Aman-Sangram/Under_water-localisation/rov 8 inch mounting/1.PNG

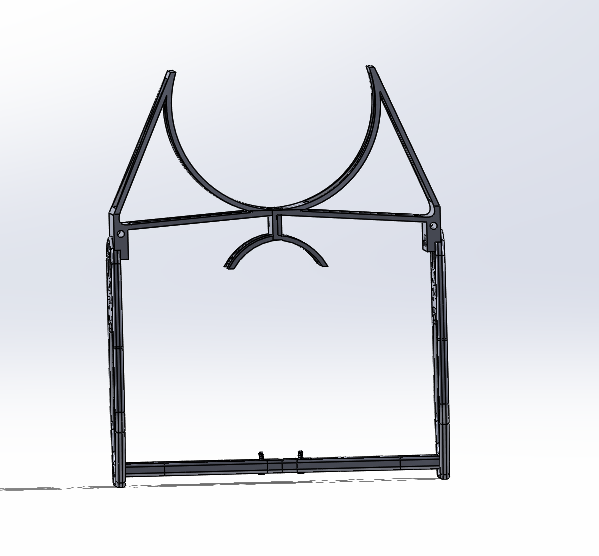
rov 8 inch mounting/1.PNG
