Aman-Sangram/Under_water-localisation/rov 8 inch mounting/2.PNG

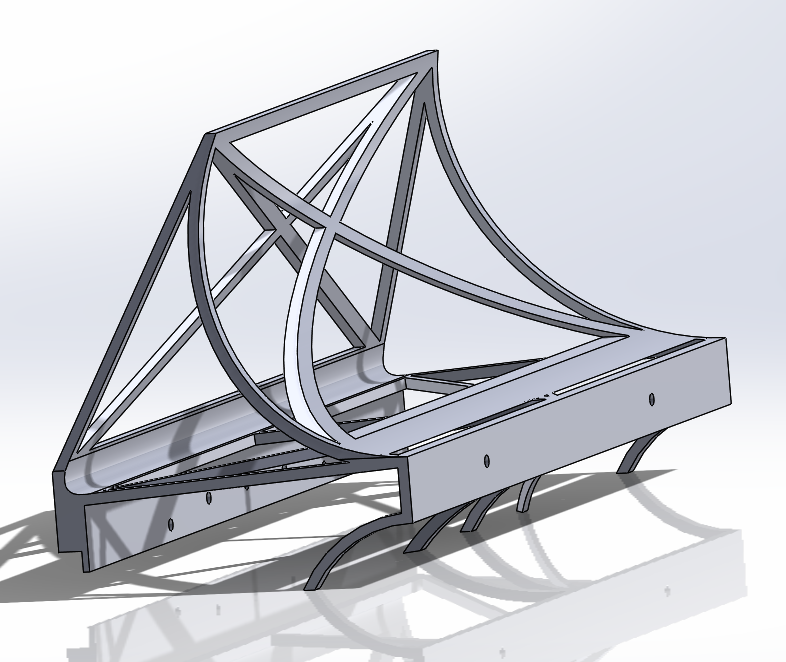
rov 8 inch mounting/2.PNG
