Aman-Sangram/Under_water-localisation/rov 8 inch mounting/3.PNG

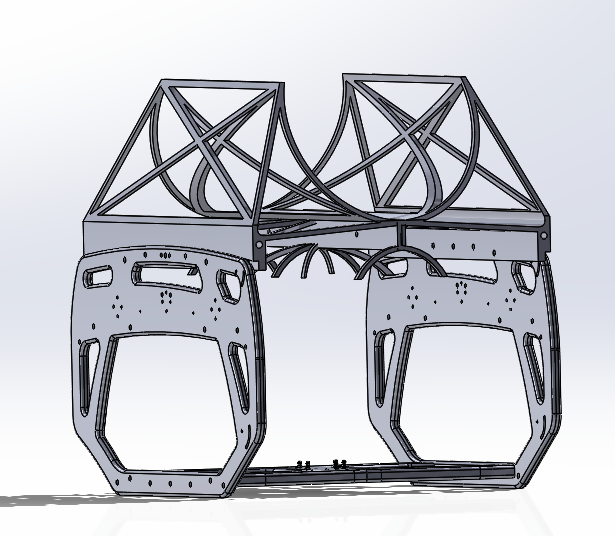
rov 8 inch mounting/3.PNG
