Aman-Sangram/Under_water-localisation/rov 8 inch mounting/6.PNG

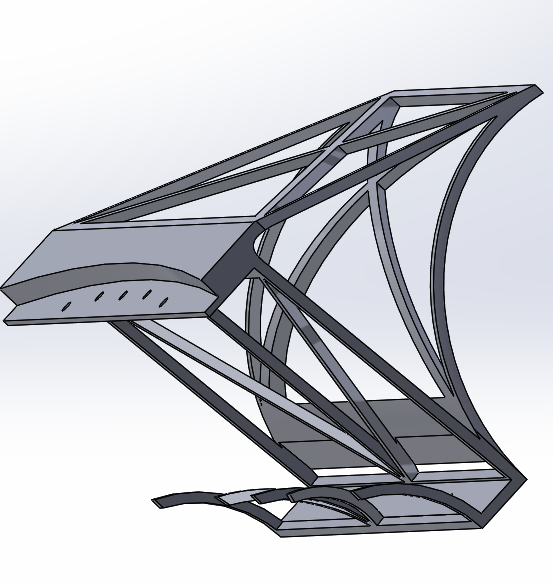
rov 8 inch mounting/6.PNG
