Aman-Sangram/Under_water-localisation/rov internal camera mounting/back.PNG

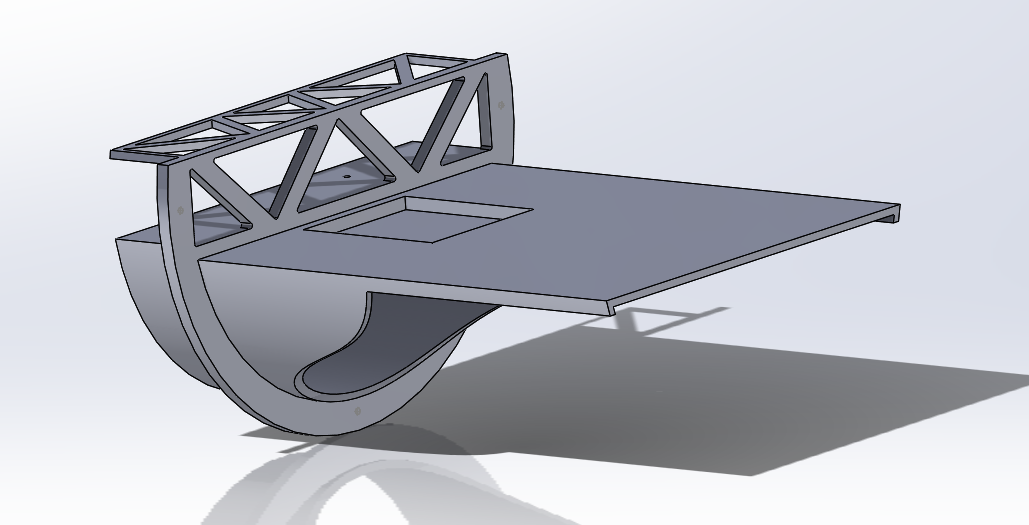
rov internal camera mounting/back.PNG
