Aman-Sangram/Under_water-localisation/rov internal camera mounting/Capture.PNG

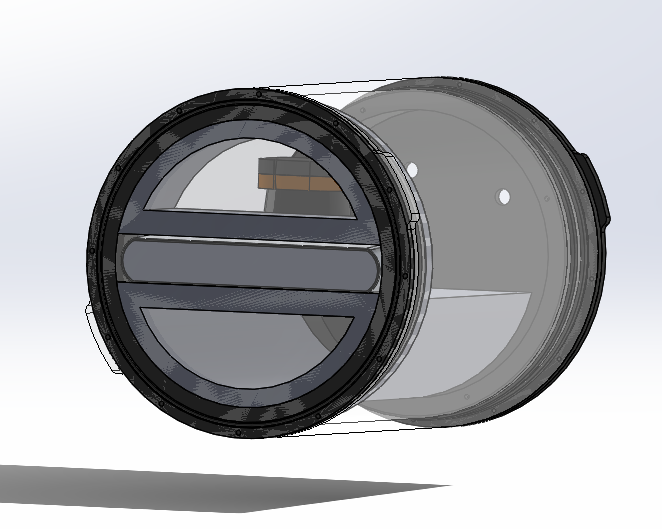
rov internal camera mounting/Capture.PNG
