Aman-Sangram/Under_water-localisation/rov internal camera mounting/down.PNG

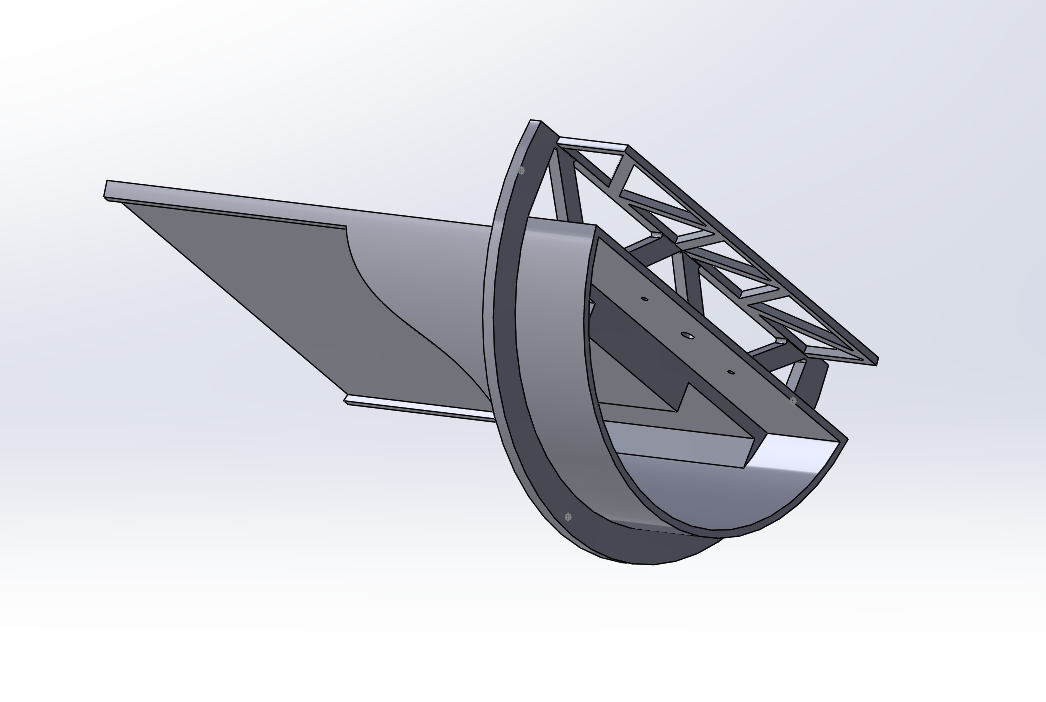
rov internal camera mounting/down.PNG
