Aman-Sangram/Under_water-localisation/rov internal camera mounting/mount.PNG

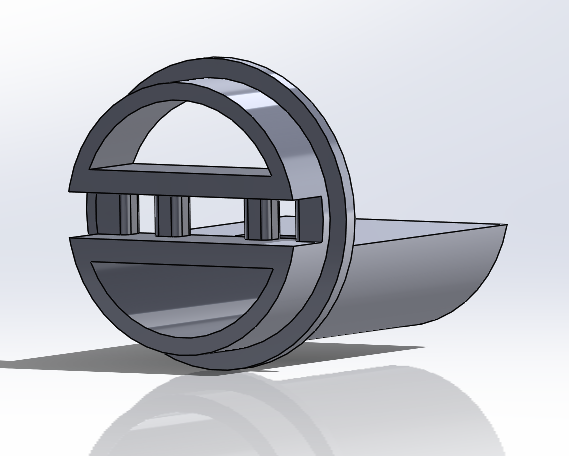
rov internal camera mounting/mount.PNG
