Aman-Sangram/Under_water-localisation/rov internal camera mounting/side.PNG

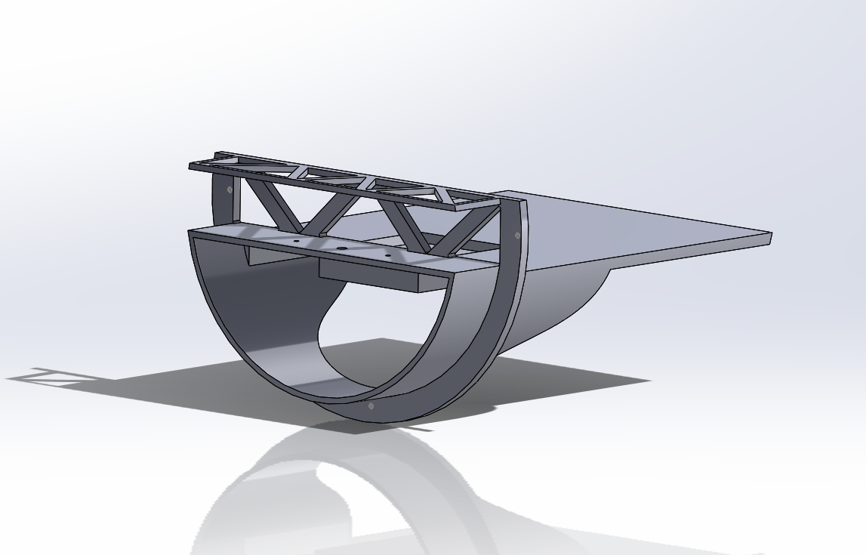
rov internal camera mounting/side.PNG
