Aman-Sangram/Under_water-localisation/rov internal camera mounting/whole front.PNG

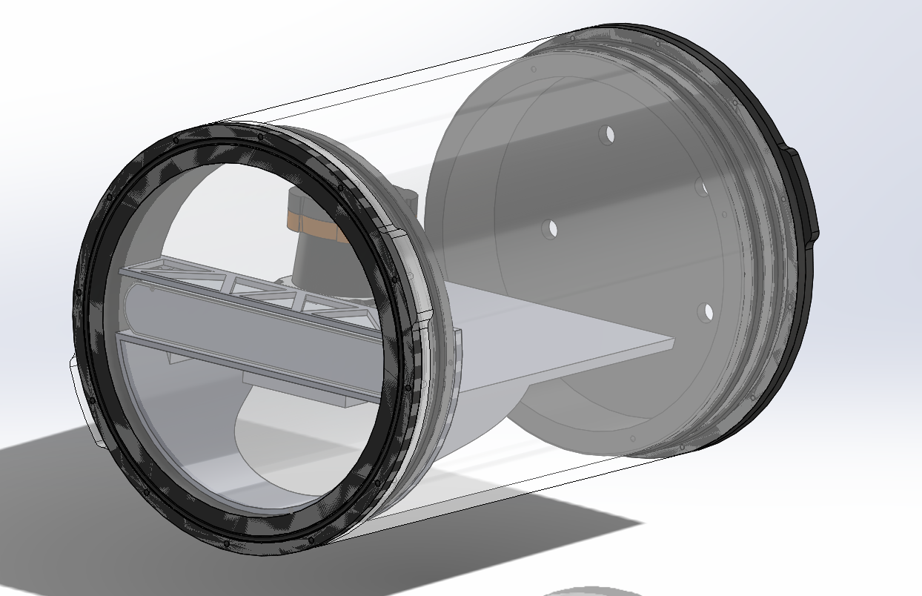
rov internal camera mounting/whole front.PNG
