Aman-Sangram/Under_water-localisation/rov internal camera mounting/wside.PNG

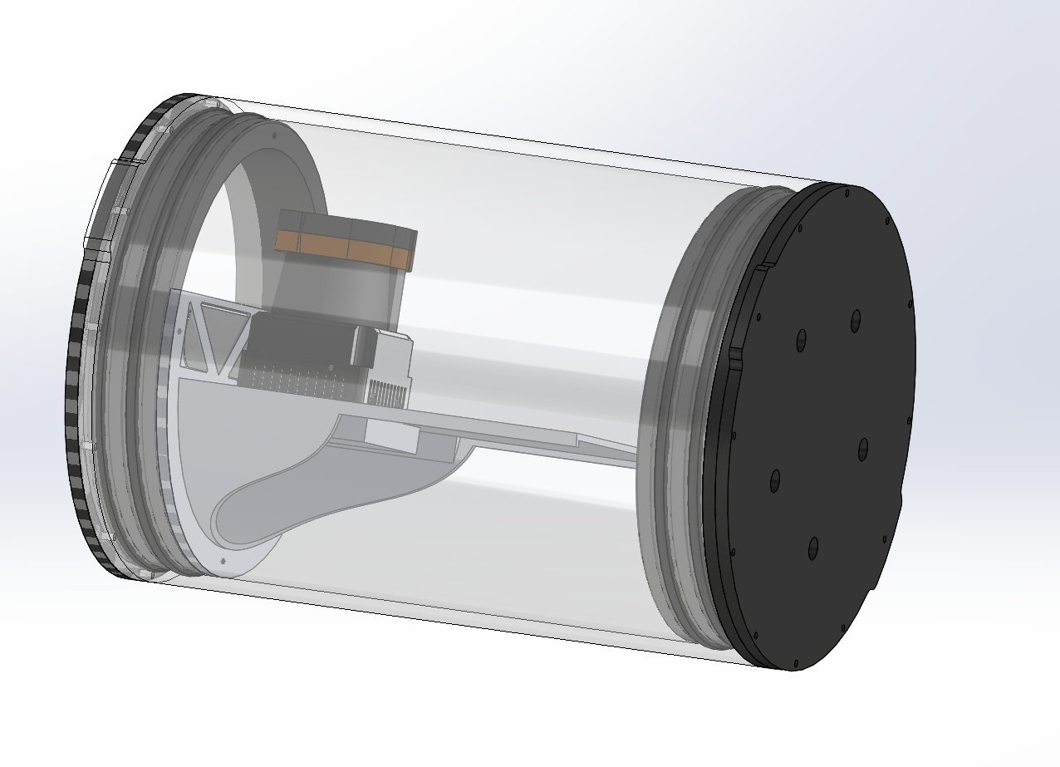
rov internal camera mounting/wside.PNG
