Aman-Sangram/Under_water-localisation/rov 8 inch mounting/bigsupport mounting.SLDASM

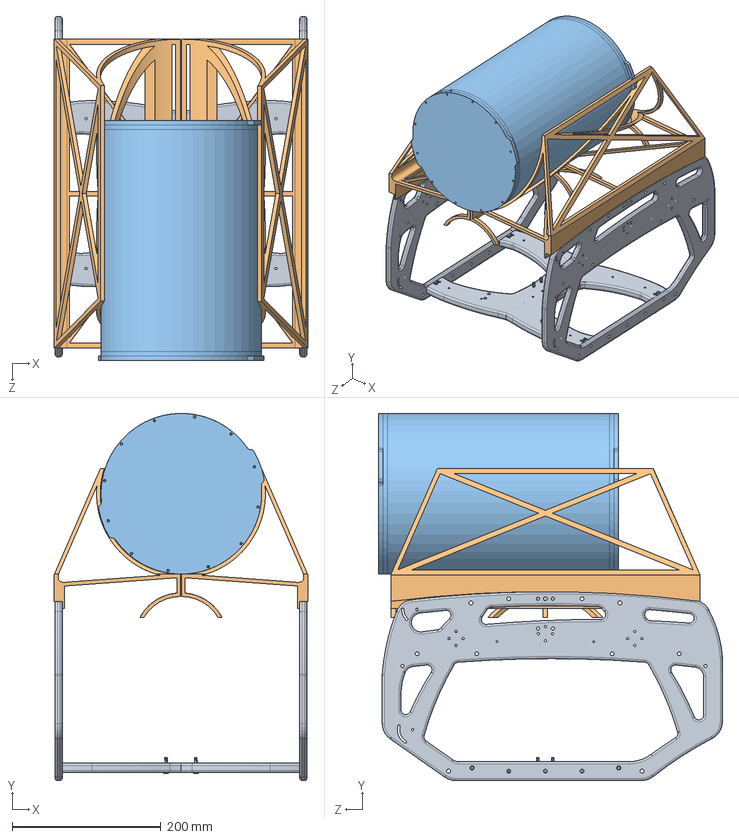
[picture p44: CAD file, 2022-02-08]
rov 8 inch mounting/bigsupport mounting.SLDASM
341.0 x 493.2 x 462.1 mm
structurre body
support x 2
WTE8-ASM-R1
