Aman-Sangram/Under_water-localisation/rov internal camera mounting/mount.SLDASM

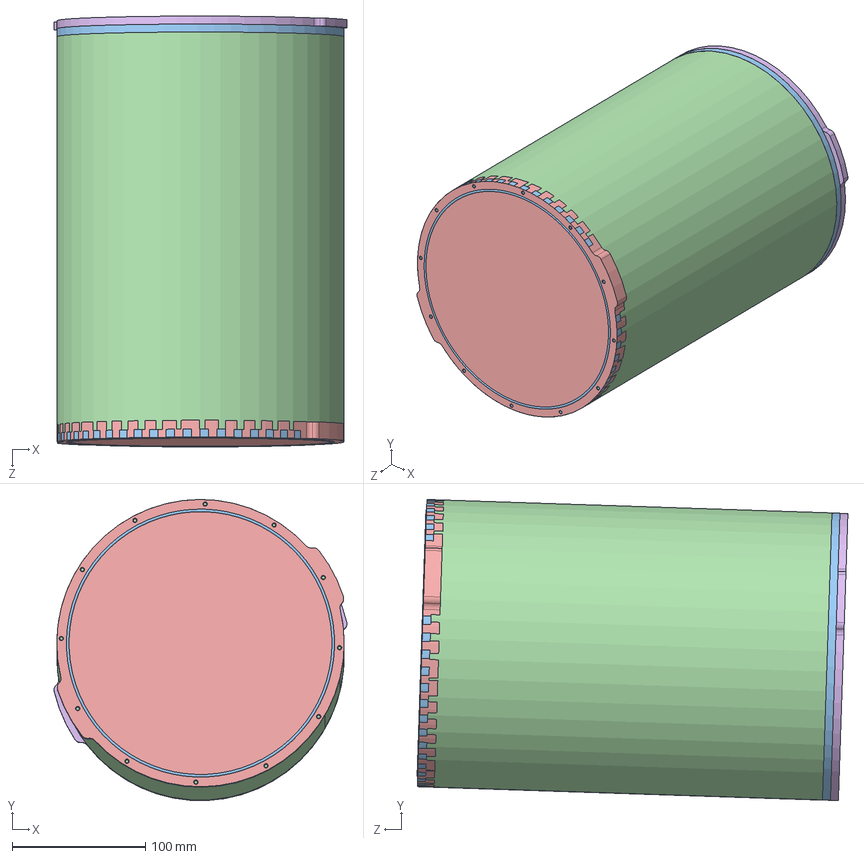
[picture p45: CAD file, 2022-02-08]
rov internal camera mounting/mount.SLDASM
220.1 x 226.2 x 323.7 mm
ZED
mount_camera
WTE8-M-FLANGE-SEAL-R1 x 2
WTE8-P-TUBE-12-R1
WTE8-P-END-CAP-R1
WTE8-M-END-CAP-5-10MM-R1
Hokuyo UTM 30LX
