Aman-Sangram/Under_water-localisation/rov internal camera mounting/ZED.SLDPRT

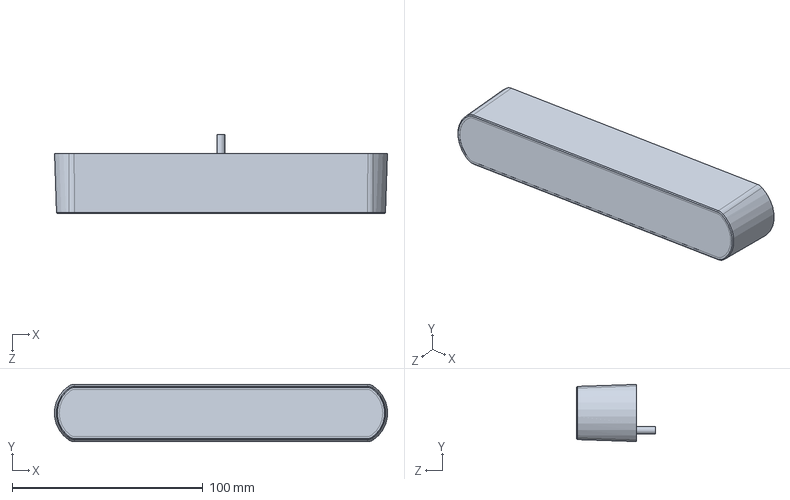
[picture p46: CAD file, 2022-02-08]
rov internal camera mounting/ZED.SLDPRT
174.8 x 30.0 x 41.5 mm
