Aman-Sangram/Under_water-localisation/rov internal camera mounting/WTE8-M-END-CAP-5-10MM-R1.SLDPRT

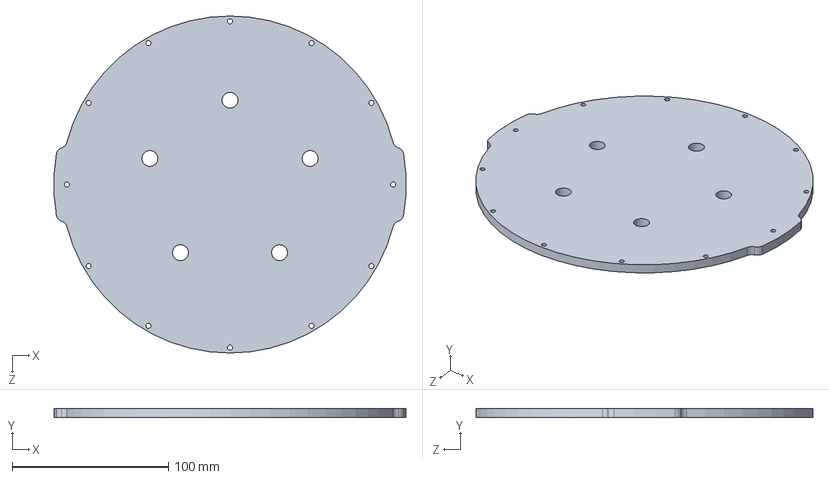
[picture p47: CAD file, 2022-02-08]
rov internal camera mounting/WTE8-M-END-CAP-5-10MM-R1.SLDPRT
225.5 x 6.00 x 215.9 mm
