Aman-Sangram/Under_water-localisation/rov internal camera mounting/mount_camera.SLDPRT

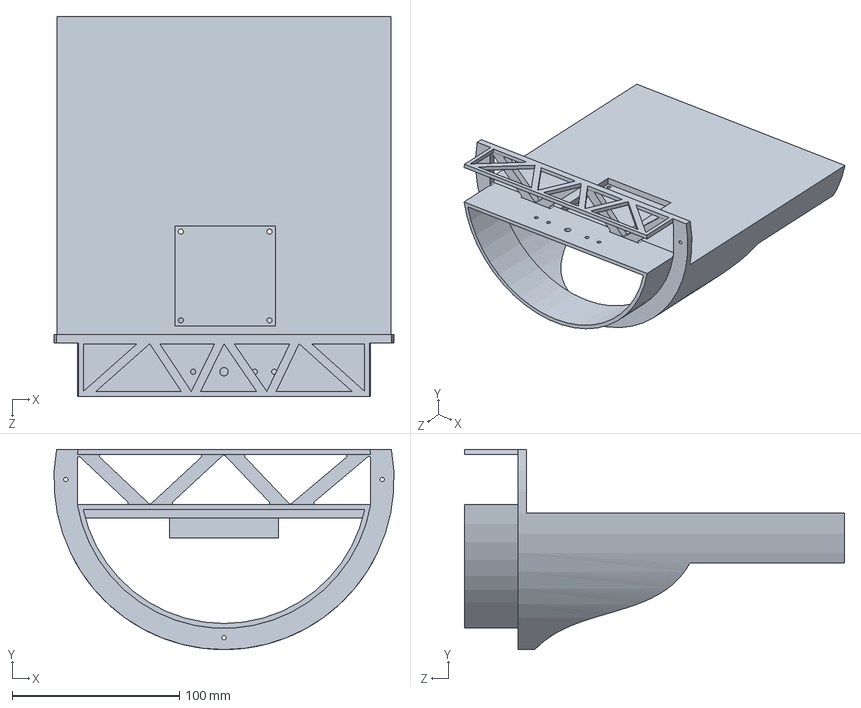
[picture p48: CAD file, 2022-02-08]
rov internal camera mounting/mount_camera.SLDPRT
202.9 x 119.6 x 227.0 mm
