Aman-Sangram/Under_water-localisation/rov internal camera mounting/WTE8-P-TUBE-12-R1.SLDPRT

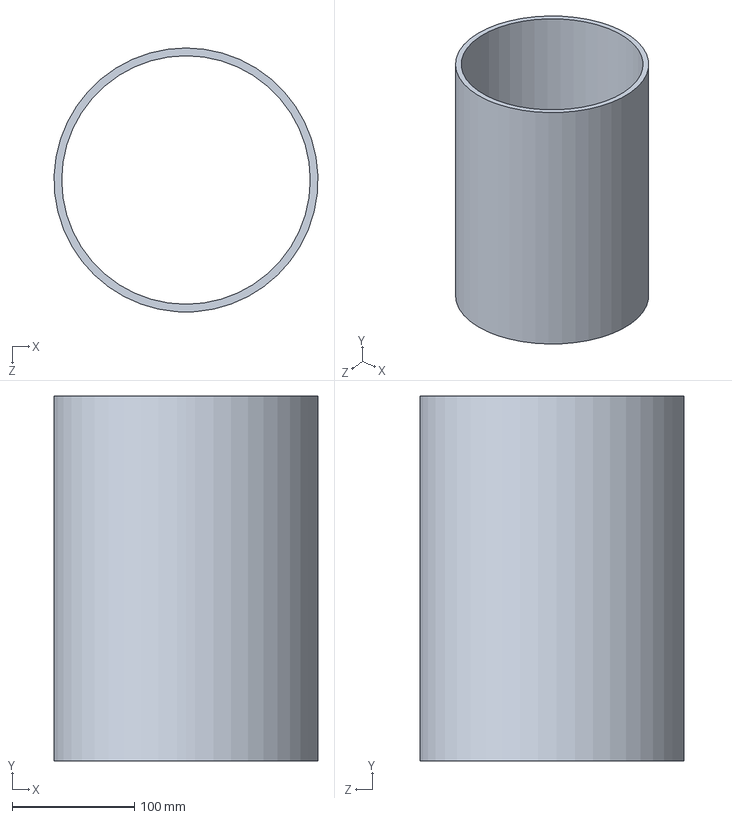
[picture p49: CAD file, 2022-02-08]
rov internal camera mounting/WTE8-P-TUBE-12-R1.SLDPRT
215.8 x 298.4 x 215.9 mm
