Aman-Sangram/Under_water-localisation/rov internal camera mounting/WTE8-M-FLANGE-SEAL-R1.SLDPRT

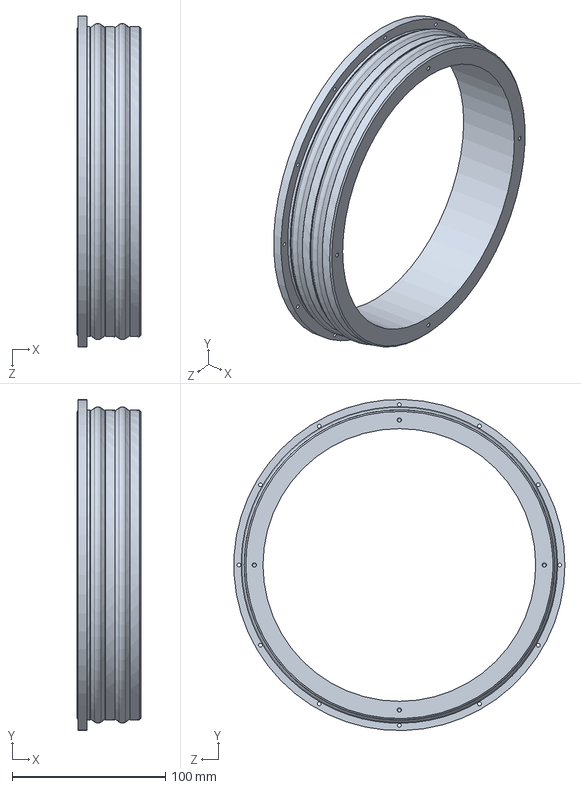
[picture p50: CAD file, 2022-02-08]
rov internal camera mounting/WTE8-M-FLANGE-SEAL-R1.SLDPRT
41.5 x 215.8 x 215.7 mm
