Aman-Sangram/Under_water-localisation/rov internal camera mounting/Hokuyo UTM 30LX.SLDPRT

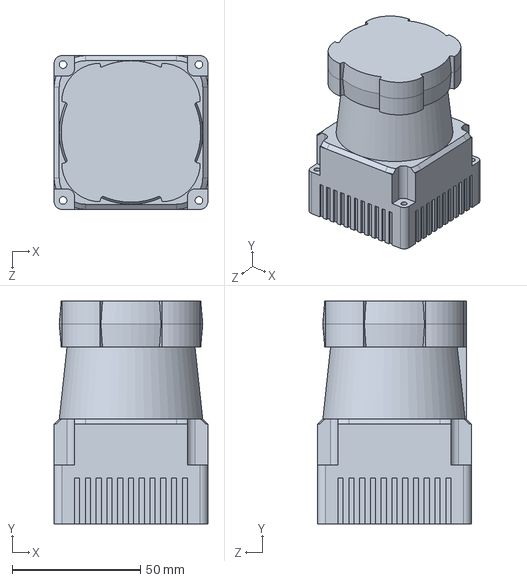
[picture p51: CAD file, 2022-02-08]
rov internal camera mounting/Hokuyo UTM 30LX.SLDPRT
60.0 x 87.0 x 60.0 mm
