Aman-Sangram/Under_water-localisation/rov internal camera mounting/mount_test.SLDPRT

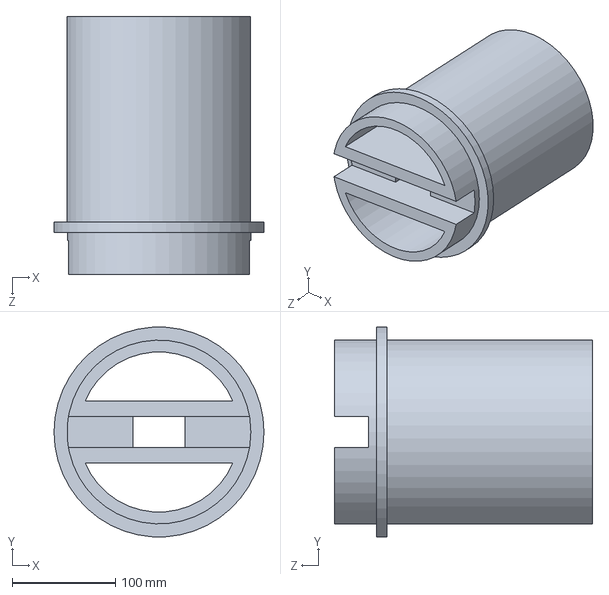
[picture p52: CAD file, 2022-02-08]
rov internal camera mounting/mount_test.SLDPRT
203.2 x 202.7 x 250.0 mm
