Aman-Sangram/Under_water-localisation/rov internal camera mounting/WTE8-P-END-CAP-R1.SLDPRT

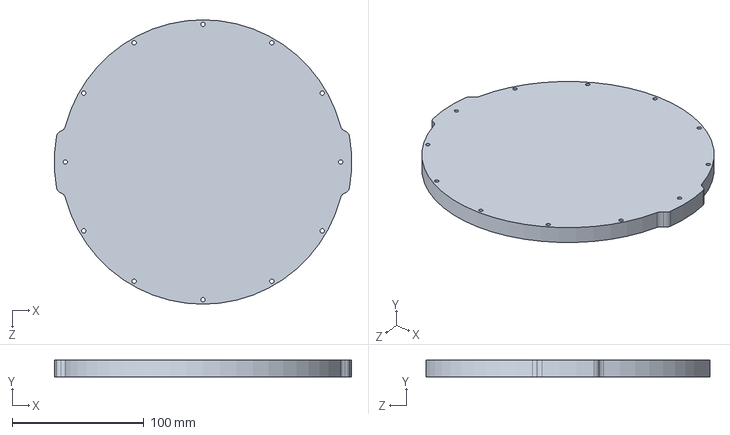
[picture p53: CAD file, 2022-02-08]
rov internal camera mounting/WTE8-P-END-CAP-R1.SLDPRT
225.5 x 12.7 x 215.9 mm
