Aman-Sangram/Under_water-localisation/(list of files, cad)

Other CAD files:
rov internal camera mounting/mount_camera.STL
