Aman-Sangram/Under_water-localisation/assembly and result pics/assembly.PNG

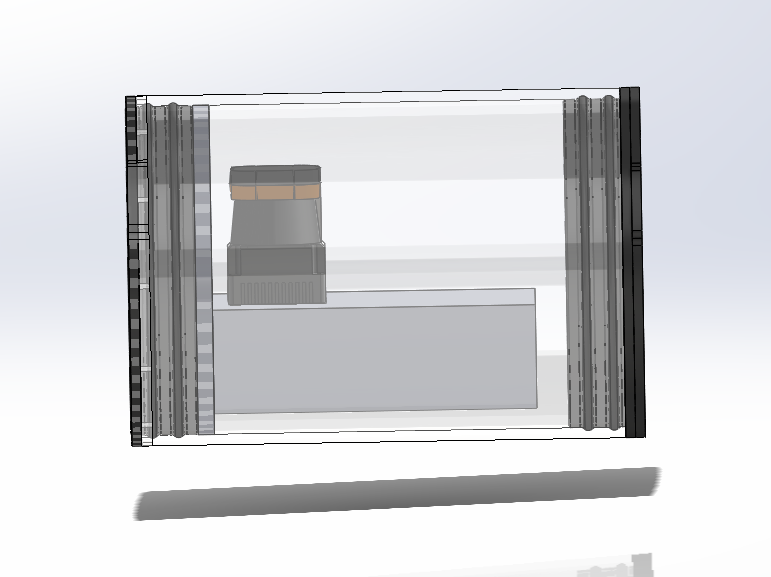
assembly and result pics/assembly.PNG
