Aman-Sangram/Under_water-localisation/assembly and result pics/IMG_20210518_130647.jpg

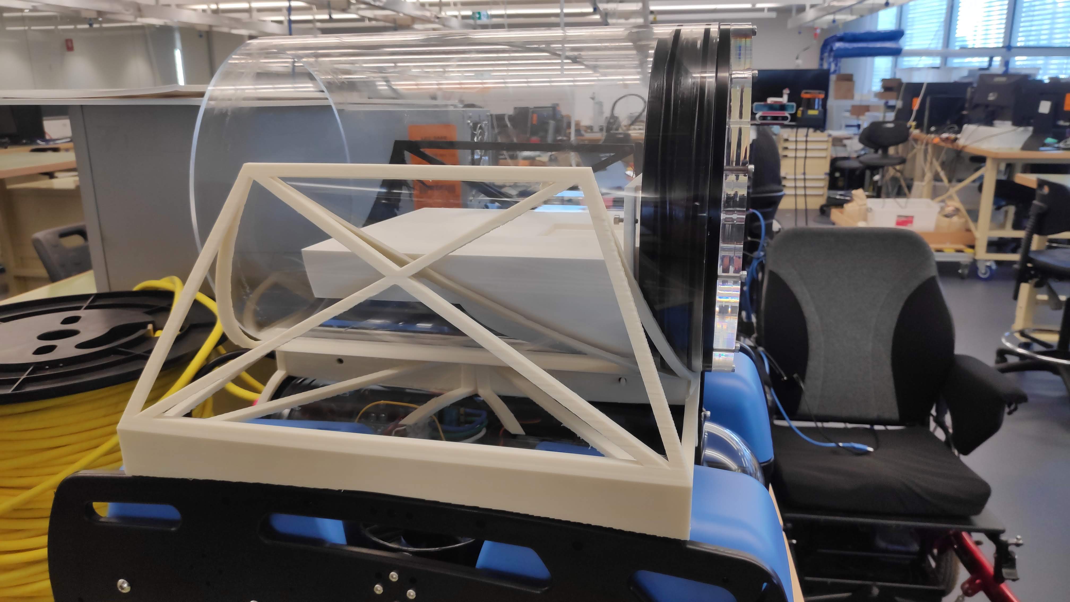
assembly and result pics/IMG_20210518_130647.jpg
