Aman-Sangram/Under_water-localisation/assembly and result pics/IMG_20210523_134254_1.jpg

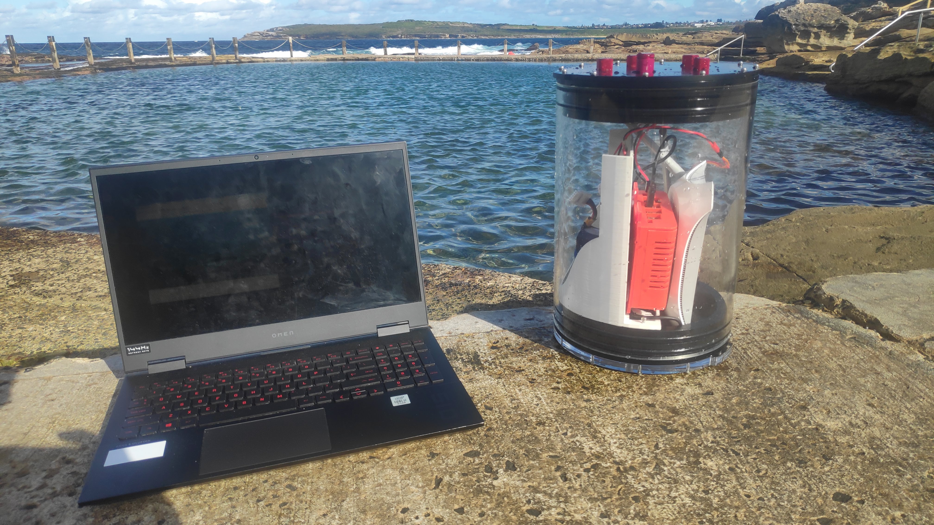
assembly and result pics/IMG_20210523_134254_1.jpg
