Aman-Sangram/Under_water-localisation/assembly and result pics/Screenshot from 2021-06-01 15-15-16.png

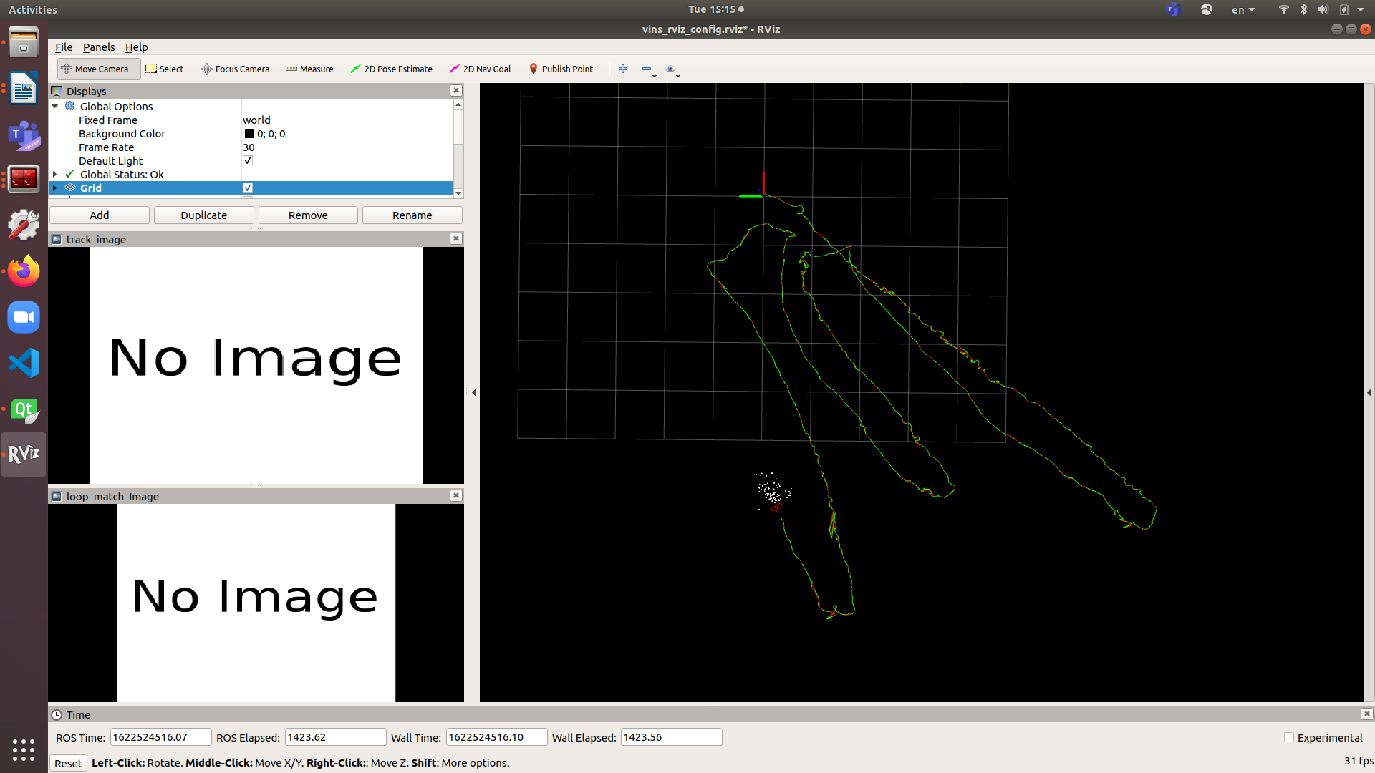
assembly and result pics/Screenshot from 2021-06-01 15-15-16.png
