Aman-Sangram/Under_water-localisation/assembly and result pics/Screenshot from 2021-06-01 17-08-01.png

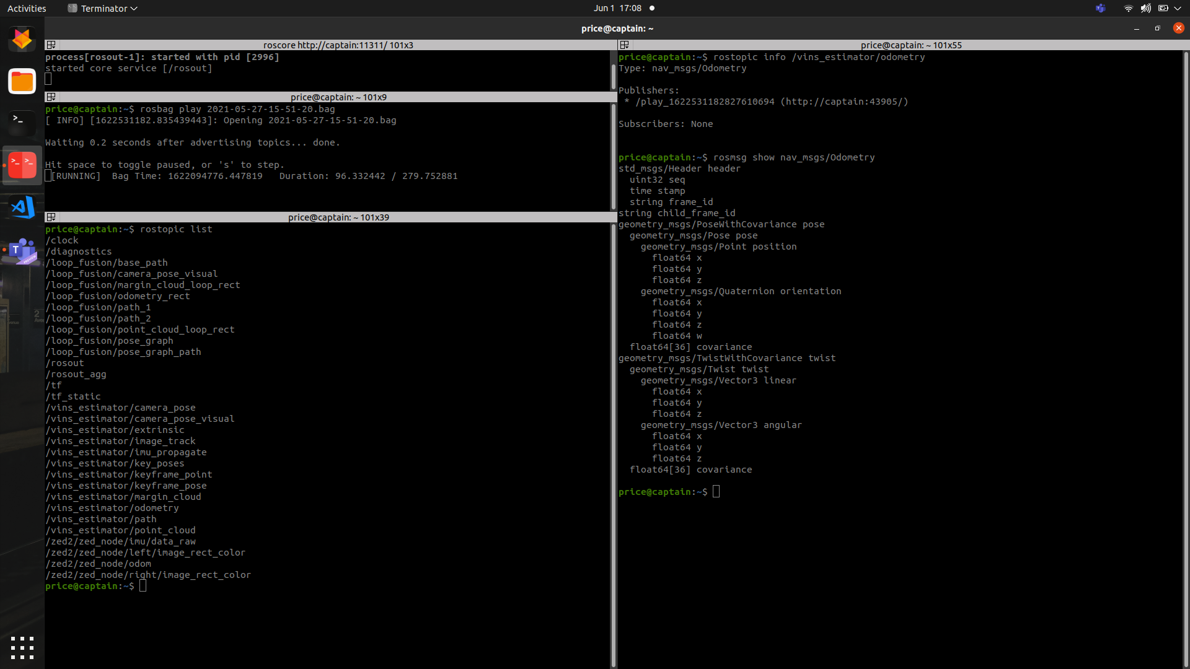
assembly and result pics/Screenshot from 2021-06-01 17-08-01.png
