Aman-Sangram/Under_water-localisation/assembly and result pics/Screenshot from 2021-06-01 17-09-39.png

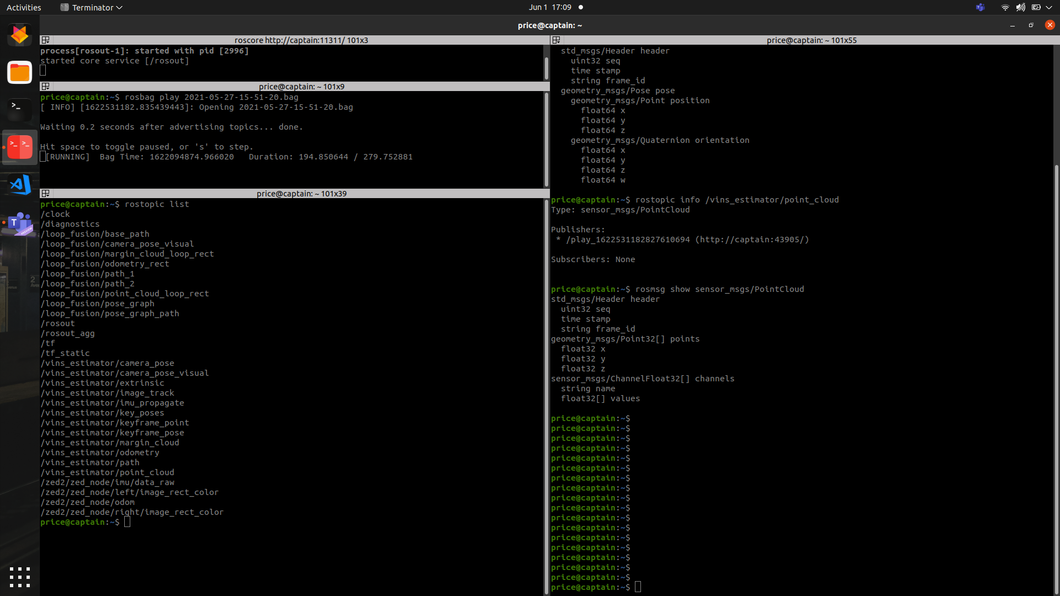
assembly and result pics/Screenshot from 2021-06-01 17-09-39.png
