Aman-Sangram/Under_water-localisation/assembly and result pics/Screenshot from 2021-06-02 00-46-20.png

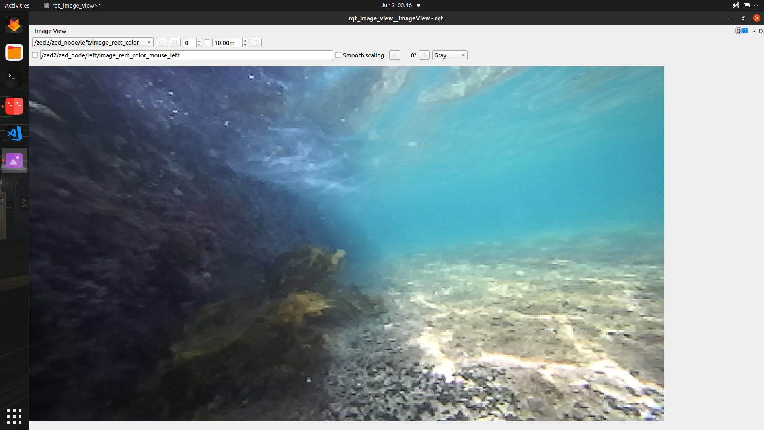
assembly and result pics/Screenshot from 2021-06-02 00-46-20.png
